54600B/ultrasonic-beacon/electronics/knowles_mic_v2/sum.asc

C1: cap; 10n
C2: cap; 1n
R1: res; 1000
R2: res; 10k
R3: res; 2k
R4: res; 50
U1: LT6233-10
V1: voltage; 3.3
V2: voltage; SINE(0 10m 40k); AC 1.
V3: voltage; 1.65
Named nets: 0, +3V3, +1V6, out
.ac oct 100 100 100meg
;tran 0 100m 99m startup
