54600B/ultrasonic-beacon/electronics/baseboard_v3rf/dac_filter.asc

C1: cap; 1n
C2: cap; 1n
R1: res; 3k3
R2: res; 8k2
R3: res; 330
U1: LT1007
V1: voltage; 10
V2: voltage; AC 1.
Named nets: 0
.ac oct 100 1k 100meg
