54600B/ultrasonic-beacon/electronics/knowles_mic_v2/knowles_mic_v2.brd

## EAGLE design electronics/knowles_mic_v2/knowles_mic_v2.brd (2018-10-21)

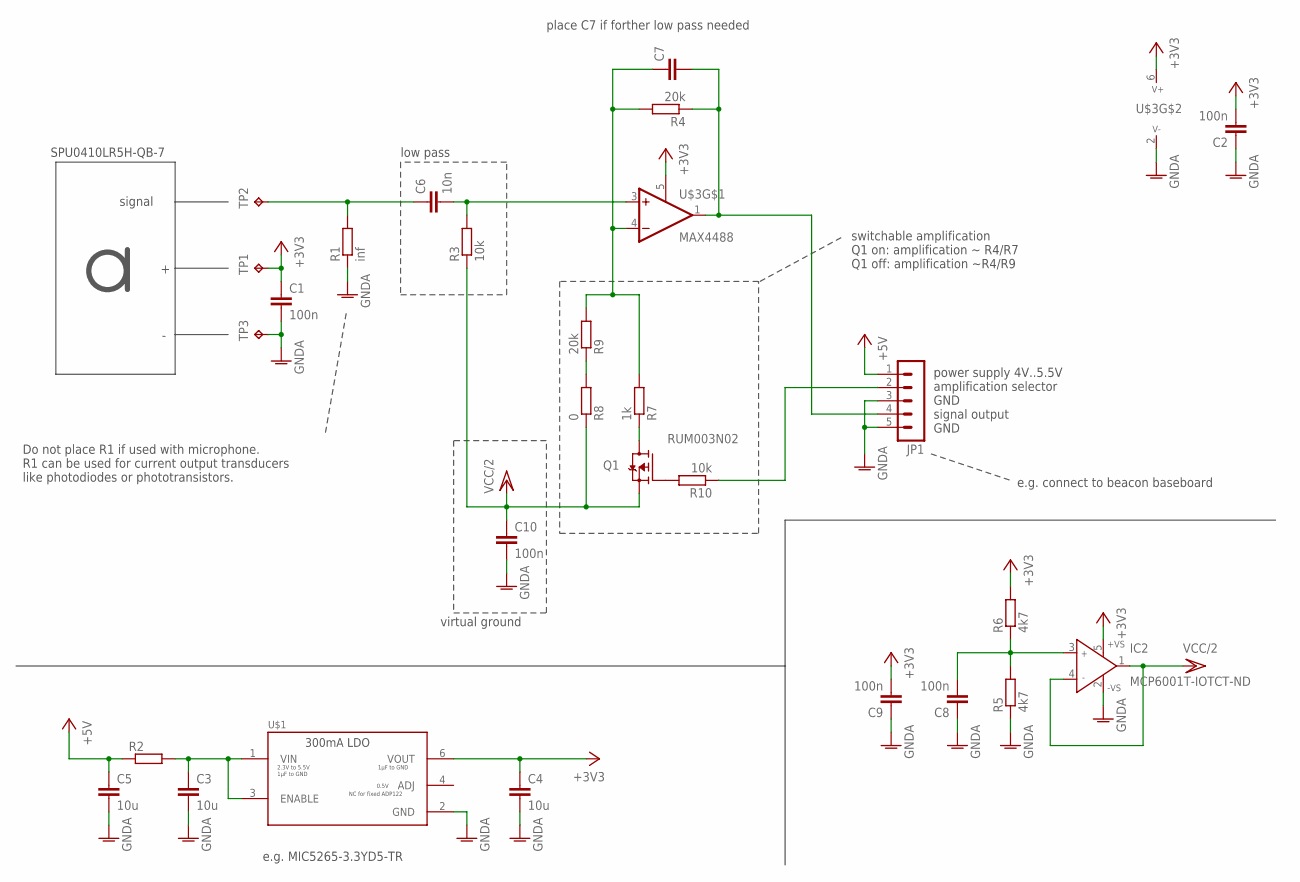
[picture p13: schematic knowles_mic_v2.sch]

Parts:
C1, C2, C8, C9, C10: 100n; C0603
C3, C4, C5: 10u; C0805
C6: 10n; C0603
C7: C-EUC0603; C0603
IC2: MCP6001T-IOTCT-ND; SOT23-5
JP1: PSS_5G; 22-23-2051
Q1: RUM003N02; SC75_INFINEON
R1: inf; R0603
R2: R-EU_R0603; R0603
R3, R10: 10k; R0603
R4, R9: 20k; R0603
R5, R6: 4k7; R0603
R7: 1k; R0603
R8: 0; R0603
TP1, TP2, TP3: TPTP06R; TP06R
U$1: ADP123; TSOT23-6
U$3: MAX4488; TSOT23-6

Connections:
+3V3: C1.1, C2.2, C4.1, C9.2, IC2.5 (+VS), R6.2, TP1.TP, U$1.6 (VOUT), U$3.5 (EN), U$3.6 (V+)
+5V: C5.1, JP1.1, R2.1
GNDA: C1.2, C2.1, C3.2, C4.2, C5.2, C8.1, C9.1, C10.2, IC2.2 (-VS), JP1.3, JP1.5, R1.1, R5.1, TP3.TP, U$1.2 (GND), U$3.2 (V-)
unnamed: C8.2, IC2.3 (IN+), R5.2, R6.1
unnamed: R8.2, R9.1
unnamed: C3.1, R2.2, U$1.1 (VIN), U$1.3 (ENABLE)
unnamed: JP1.2, R10.1
unnamed: Q1.1 (G), R10.2
unnamed: Q1.2 (D), R7.1
unnamed: C6.1, R1.2, TP2.TP
unnamed: C6.2, R3.2, U$3.3 (+IN)
unnamed: C7.2, JP1.4, R4.1, U$3.1 (OUT)
unnamed: C7.1, R4.2, R7.2, R9.2, U$3.4 (-IN)
VCC/2: C10.1, IC2.1 (OUT), IC2.4 (IN-), Q1.3 (S), R3.1, R8.1

Notes on the sheet:
e.g. MIC5265-3.3YD5-TR
signal
SPU0410LR5H-QB-7
Do not place R1 if used with microphone. R1 can be used for current output transducers like photodiodes or phototransistors.
low pass
place C7 if forther low pass needed
virtual ground
switchable amplification Q1 on: amplification ~ R4/R7 Q1 off: amplification ~R4/R9
power supply 4V..5.5V amplification selector GND signal output GND
e.g. connect to beacon baseboard

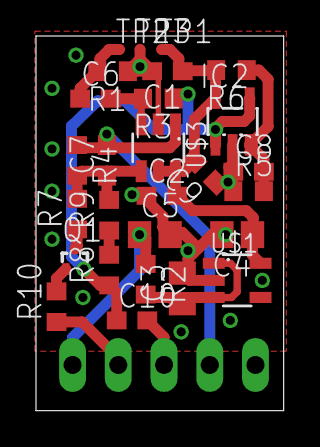
[picture p14: board knowles_mic_v2.brd from above]

Board: 2 copper layers, 13.8 x 20.8 mm, 28 parts (1 on the bottom side), 14 nets.
