54600B/ultrasonic-beacon/electronics/baseboard_v3rf/us_beacon_base_v3rf.brd

## EAGLE design electronics/baseboard_v3rf/us_beacon_base_v3rf.brd (2018-07-22)

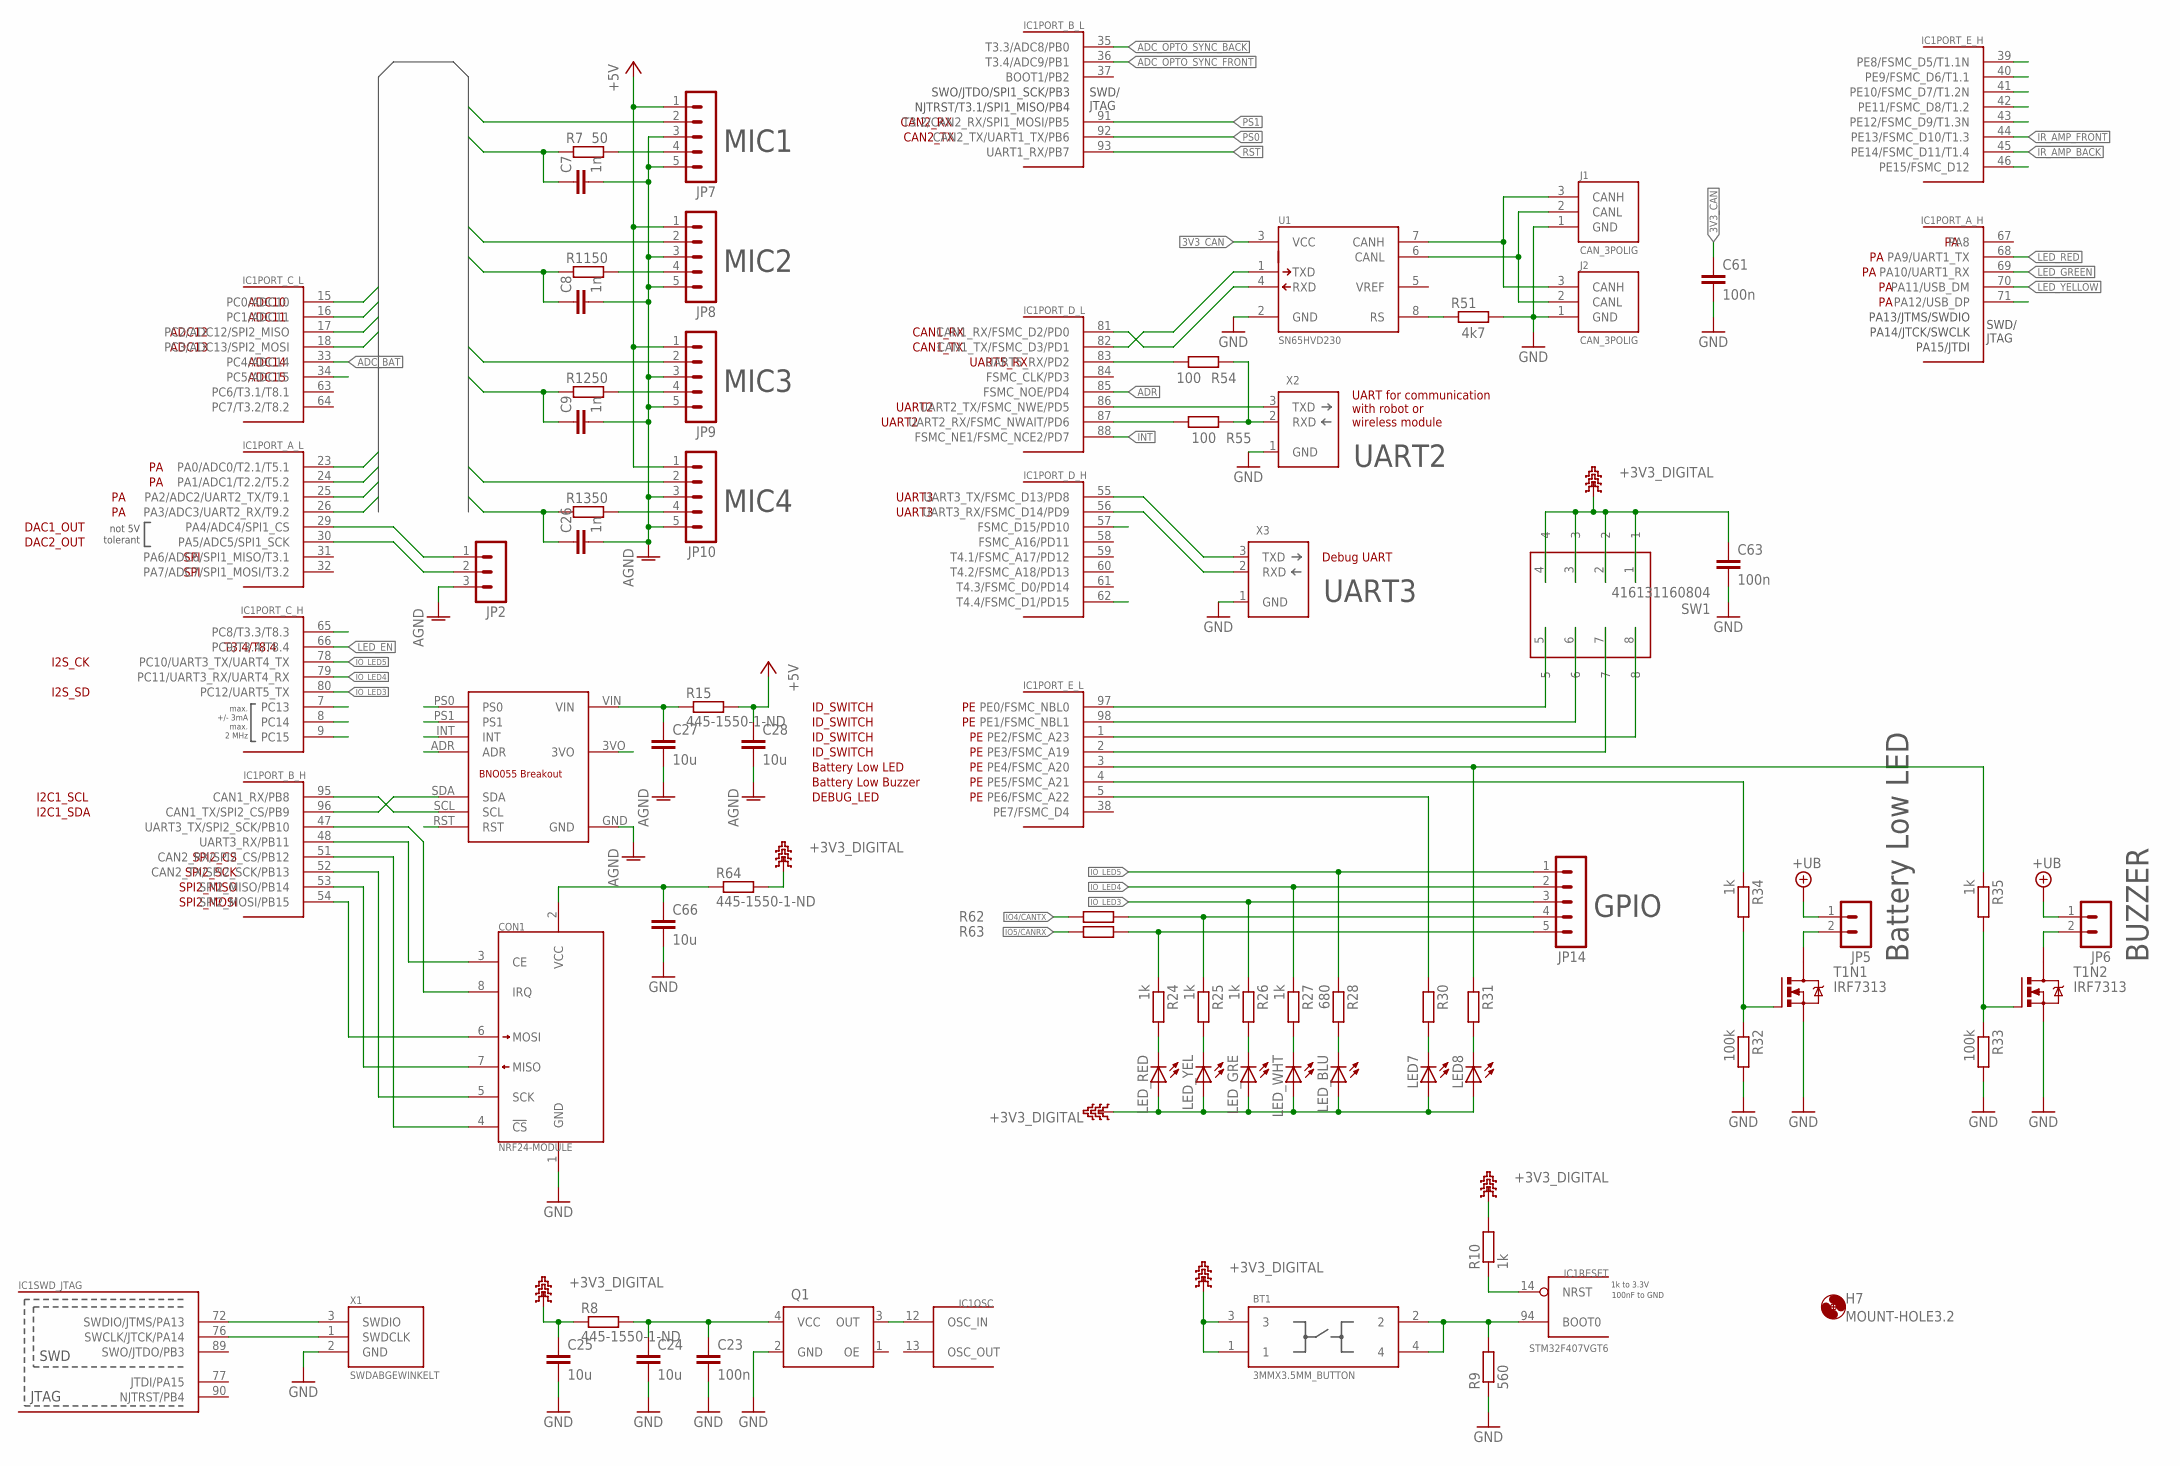
[picture p15: schematic us_beacon_base_v3rf.sch, sheet 1]

Parts:
BT1: 3MMX3.5MM_BUTTON
C7, C8, C9, C26: 1n; C0603
C23, C61, C63: 100n; C0603
C24, C25, C27, C28, C66: 10u; C0805
CON1: NRF24-MODULE
H7: MOUNT-HOLE3.2; 3,2
IC1: STM32F407VGT6; TQFP100
J1, J2: CAN_3POLIG; 7395-03
JP2: PSS_3G; 22-23-2031
JP5, JP6: PSS_2G; 22-23-2021
JP7, JP8, JP9, JP10, JP14: PSS_5G; 22-23-2051
LED7, LED8: LEDCHIP-LED0603; CHIP-LED0603
LED_BLU: LEDCHIP-LED0603; CHIP-LED0603
LED_GRE: LEDCHIP-LED0603; CHIP-LED0603
LED_RED: LEDCHIP-LED0603; CHIP-LED0603
LED_WHT: LEDCHIP-LED0603; CHIP-LED0603
LED_YEL: LEDCHIP-LED0603; CHIP-LED0603
Q1: XO53
R7, R11, R12, R13: 50; R0603
R8, R15, R64: 445-1550-1-ND; R0603
R9: 560; R0603
R10, R24, R25, R26, R27, R34, R35: 1k; R0603
R28: 680; R0603
R30, R31, R62, R63: R-EU_R0603; R0603
R32, R33: 100k; R0603
R51: 4k7; R0603
R54, R55: 100; R0603
SW1: 416131160804
T1: IRF7313; SO08
U1: SN65HVD230; SOIC-8
U$1: BNO055_ADAFRUIT_BREAKOUT; BNO055_BREAKOUT
X1: SWDABGEWINKELT; 7395-03
X2, X3: SERIAL_DEBUG_3PINL; 7395-03

Connections:
3V3_CAN: C61.1, U1.3 (VCC); also elsewhere on the board
+3V3_DIGITAL: BT1.1, BT1.3, C25.1, C63.1, LED7.A, LED8.A, LED_BLU.A, LED_GRE.A, LED_RED.A, LED_WHT.A, LED_YEL.A, R8.1, R10.2, R64.2, SW1.1, SW1.2, SW1.3, SW1.4; also elsewhere on the board
+5V: C28.1, JP7.1, JP8.1, JP9.1, JP10.1, R15.2; also elsewhere on the board
+UB: JP5.1, JP6.1; also elsewhere on the board
ADC_BAT: IC1.33 (PC4/ADC14); also elsewhere on the board
ADC_OPTO_SYNC_BACK: IC1.35 (T3.3/ADC8/PB0); also elsewhere on the board
ADC_OPTO_SYNC_FRONT: IC1.36 (T3.4/ADC9/PB1); also elsewhere on the board
ADR: IC1.85 (FSMC_NOE/PD4), U$1.ADR
AMP1: IC1.23 (PA0/ADC0/T2.1/T5.1), JP7.2
AMP2: IC1.24 (PA1/ADC1/T2.2/T5.2), JP8.2
AMP3: IC1.25 (PA2/ADC2/UART2_TX/T9.1), JP9.2
AMP4: IC1.26 (PA3/ADC3/UART2_RX/T9.2), JP10.2
DAC1/I2S1_WS: IC1.29 (PA4/ADC4/SPI1_CS), JP2.1
DAC2/SPI1_SCK: IC1.30 (PA5/ADC5/SPI1_SCK), JP2.2
GND: C7.2, C8.2, C9.2, C23.2, C24.2, C25.2, C26.2, C27.2, C28.2, C61.2, C63.2, C66.2, CON1.1 (GND), J1.1 (GND), J2.1 (GND), JP2.3, JP7.3, JP7.5, JP8.3, JP8.5, JP9.3, JP9.5, JP10.3, JP10.5, Q1.2 (GND), R9.1, R32.2, R33.2, R51.2, T1.1 (S), T1.3 (S), U1.2 (GND), U$1.GND, X1.2 (GND), X2.1 (GND), X3.1 (GND); also elsewhere on the board
INT: IC1.88 (FSMC_NE1/FSMC_NCE2/PD7), U$1.INT
IO4: JP14.4, R25.1, R62.2
IO4/CANTX: IC1.82 (CAN1_TX/FSMC_D3/PD1), R62.1, U1.1 (TXD)
IO5: JP14.5, R24.1, R63.2
IO5/CANRX: IC1.81 (CAN1_RX/FSMC_D2/PD0), R63.1, U1.4 (RXD)
IO_LED3: IC1.80 (PC12/UART5_TX), JP14.3, R26.1
IO_LED4: IC1.79 (PC11/UART3_RX/UART4_RX), JP14.2, R27.1
IO_LED5: IC1.78 (PC10/UART3_TX/UART4_TX), JP14.1, R28.1
IR_AMP_BACK: IC1.45 (PE14/FSMC_D11/T1.4); also elsewhere on the board
IR_AMP_FRONT: IC1.44 (PE13/FSMC_D10/T1.3); also elsewhere on the board
LED_EN: IC1.66 (PC9/T3.4/T8.4); also elsewhere on the board
LED_GREEN: IC1.69 (PA10/UART1_RX); also elsewhere on the board
LED_RED: IC1.68 (PA9/UART1_TX); also elsewhere on the board
LED_YELLOW: IC1.70 (PA11/USB_DM); also elsewhere on the board
MIC1: C7.1, IC1.15 (PC0/ADC10), R7.1
MIC2: C8.1, IC1.16 (PC1/ADC11), R11.1
MIC3: C9.1, IC1.17 (PC2/ADC12/SPI2_MISO), R12.1
MIC4: C26.1, IC1.18 (PC3/ADC13/SPI2_MOSI), R13.1
unnamed: IC1.72 (SWDIO/JTMS/PA13), X1.3 (SWDIO)
unnamed: IC1.76 (SWCLK/JTCK/PA14), X1.1 (SWDCLK)
unnamed: JP7.4, R7.2
unnamed: IC1.12 (OSC_IN), Q1.3 (OUT)
unnamed: C23.1, C24.1, Q1.4 (VCC), R8.2
unnamed: JP9.4, R12.2
unnamed: IC1.14 (NRST), R10.1
unnamed: JP8.4, R11.2
unnamed: JP10.4, R13.2
unnamed: BT1.2, BT1.4, IC1.94 (BOOT0), R9.2
unnamed: IC1.83 (UART5_RX/PD2), R54.1
unnamed: C27.1, R15.1, U$1.VIN
unnamed: R54.2, R55.2, X2.2 (RXD)
unnamed: IC1.95 (CAN1_RX/PB8), U$1.SCL
unnamed: IC1.96 (CAN1_TX/SPI2_CS/PB9), U$1.SDA
unnamed: IC1.86 (UART2_TX/FSMC_NWE/PD5), X2.3 (TXD)
unnamed: IC1.87 (UART2_RX/FSMC_NWAIT/PD6), R55.1
unnamed: IC1.55 (UART3_TX/FSMC_D13/PD8), X3.3 (TXD)
unnamed: IC1.56 (UART3_RX/FSMC_D14/PD9), X3.2 (RXD)
unnamed: LED_RED.C, R24.2
unnamed: LED_YEL.C, R25.2
unnamed: LED_GRE.C, R26.2
unnamed: LED_WHT.C, R27.2
unnamed: LED_BLU.C, R28.2
unnamed: LED7.C, R30.2
unnamed: LED8.C, R31.2
unnamed: IC1.3 (PE4/FSMC_A20), R31.1, R35.1
unnamed: IC1.5 (PE6/FSMC_A22), R30.1
unnamed: R32.1, R34.2, T1.2 (G)
unnamed: R33.1, R35.2, T1.4 (G)
unnamed: JP5.2, T1.7 (D)
unnamed: IC1.4 (PE5/FSMC_A21), R34.1
unnamed: JP6.2, T1.5 (D)
unnamed: IC1.2 (PE3/FSMC_A19), SW1.7
unnamed: IC1.97 (PE0/FSMC_NBL0), SW1.5
unnamed: IC1.98 (PE1/FSMC_NBL1), SW1.6
unnamed: IC1.1 (PE2/FSMC_A23), SW1.8
unnamed: R51.1, U1.8 (RS)
unnamed: J1.3 (CANH), J2.3 (CANH), U1.7 (CANH)
unnamed: J1.2 (CANL), J2.2 (CANL), U1.6 (CANL)
unnamed: CON1.4 (!CS), IC1.51 (CAN2_RX/SPI2_CS/PB12)
unnamed: CON1.5 (SCK), IC1.52 (CAN2_TX/SPI2_SCK/PB13)
unnamed: CON1.7 (MISO), IC1.53 (SPI2_MISO/PB14)
unnamed: CON1.6 (MOSI), IC1.54 (SPI2_MOSI/PB15)
unnamed: CON1.3 (CE), IC1.48 (UART3_RX/PB11)
unnamed: CON1.8 (IRQ), IC1.47 (UART3_TX/SPI2_SCK/PB10)
unnamed: C66.1, CON1.2 (VCC), R64.1
PS0: IC1.92 (CAN2_TX/UART1_TX/PB6), U$1.PS0
PS1: IC1.91 (T3.2/CAN2_RX/SPI1_MOSI/PB5), U$1.PS1
RST: IC1.93 (UART1_RX/PB7), U$1.RST
VBAT: IC1.6 (VBAT)

Notes on the sheet:
ADC11
SPI2_CS
SPI2_SCK
CAN1_RX
CAN1_TX
SPI2_MOSI
SPI2_MISO
ADC10
ADC14
ADC15
UART2
UART3
DAC1_OUT
DAC2_OUT
I2S_CK
I2S_SD
SPI
CAN2_RX
CAN2_TX
I2C1_SCL
I2C1_SDA
ADC12
ADC13
ID_SWITCH
Battery Low LED
Battery Low Buzzer
DEBUG_LED
MIC1
MIC2
MIC3
MIC4
GPIO
BUZZER
Debug UART
UART for communication with robot or wireless module
T3.4/T8.4
UART5_RX

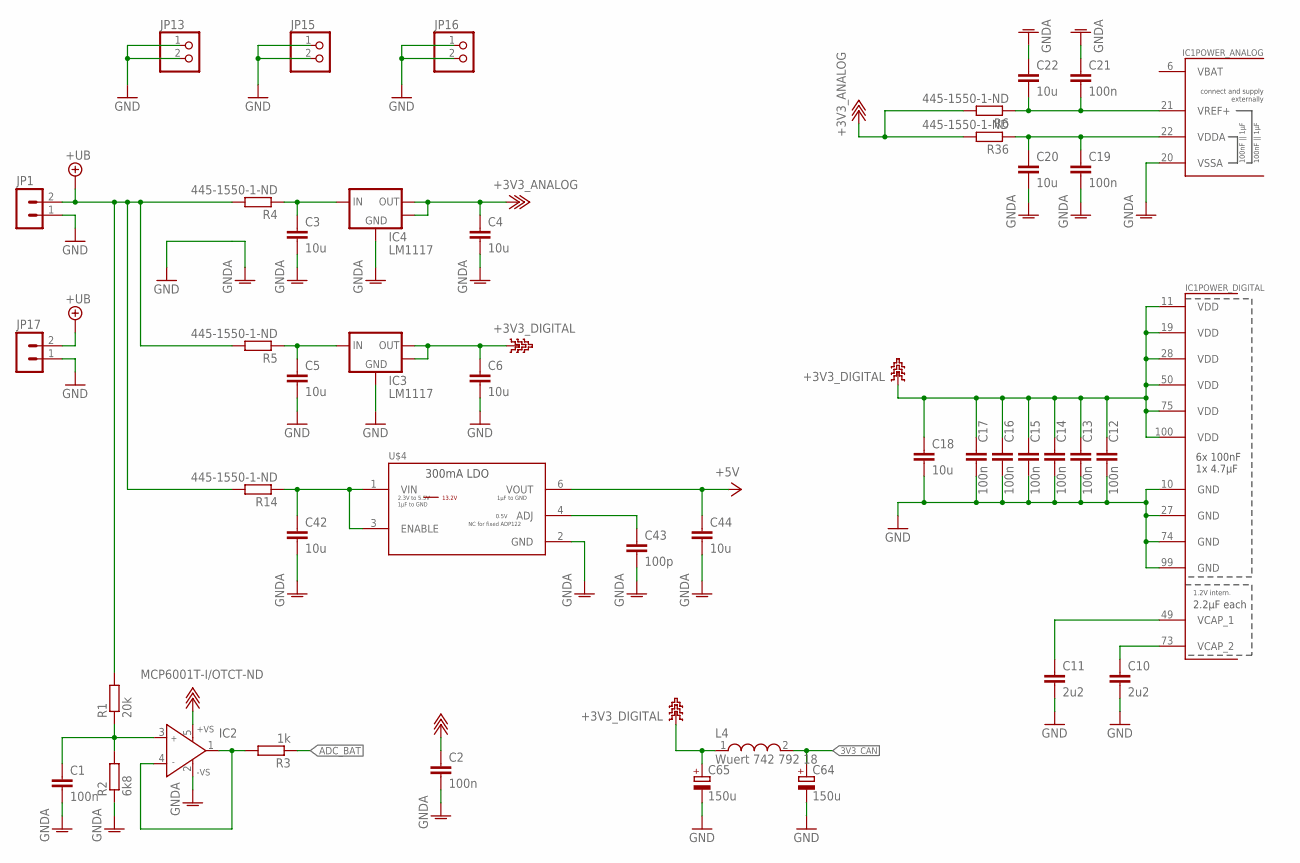
[picture p16: schematic us_beacon_base_v3rf.sch, sheet 2]

Parts:
C1, C2, C12, C13, C14, C15, C16, C17, C19, C21: 100n; C0603
C3, C4, C5, C6, C18, C20, C22, C42, C44: 10u; C0805
C10, C11: 2u2; C0805
C43: 100p; C0603
C64, C65: 150u; E3,5-8
IC1: STM32F407VGT6; TQFP100
IC2: MCP6001T-I/OTCT-ND; SOT23-5
IC3, IC4: LM1117; SOT223
JP1, JP17: PSS_2G; 22-23-2021
JP13, JP15, JP16: PINHD-1X2; 1X02
L4: Wuert 742 792 18; WE-CBF_1206(W=5.2)
R1: 20k; R0603
R2: 6k8; R0603
R3: 1k; R0603
R4, R5, R6, R14, R36: 445-1550-1-ND; R0603
U$4: AP2210K-5.0; TSOT23-6

Connections:
3V3_CAN: C64.+, L4.2; also elsewhere on the board
+3V3_ANALOG: C2.1, C4.1, IC2.5 (+VS), IC4.2 (OUT), IC4.4 (OUT), R6.2, R36.2; also elsewhere on the board
+3V3_DIGITAL: C6.1, C12.1, C13.1, C14.1, C15.1, C16.1, C17.1, C18.1, C65.+, IC1.11 (VDD), IC1.19 (VDD), IC1.28 (VDD), IC1.50 (VDD), IC1.75 (VDD), IC1.100 (VDD), IC3.2 (OUT), IC3.4 (OUT), L4.1; also elsewhere on the board
+5V: C44.1, U$4.6 (VOUT); also elsewhere on the board
+UB: JP1.2, JP17.2, R1.2, R4.2, R5.2, R14.2; also elsewhere on the board
ADC_BAT: R3.1; also elsewhere on the board
GND: C1.2, C2.2, C3.2, C4.2, C5.2, C6.2, C10.2, C11.2, C12.2, C13.2, C14.2, C15.2, C16.2, C17.2, C18.2, C19.2, C20.2, C21.1, C22.1, C42.2, C43.2, C44.2, C64.-, C65.-, IC1.10 (GND), IC1.20 (VSSA), IC1.27 (GND), IC1.74 (GND), IC1.99 (GND), IC2.2 (-VS), IC3.1 (GND), IC4.1 (GND), JP1.1, JP13.1, JP13.2, JP15.1, JP15.2, JP16.1, JP16.2, JP17.1, R2.1, U$4.2 (GND); also elsewhere on the board
unnamed: IC2.1 (OUT), IC2.4 (IN-), R3.2
unnamed: C1.1, IC2.3 (IN+), R1.1, R2.2
unnamed: C42.1, R14.1, U$4.1 (VIN), U$4.3 (ENABLE)
unnamed: C3.1, IC4.3 (IN), R4.1
unnamed: C10.1, IC1.73 (VCAP_2)
unnamed: C5.1, IC3.3 (IN), R5.1
unnamed: C11.1, IC1.49 (VCAP_1)
unnamed: C21.2, C22.2, IC1.21 (VREF+), R6.1
unnamed: C43.1, U$4.4 (ADJ)
unnamed: C19.1, C20.1, IC1.22 (VDDA), R36.1
VBAT: IC1.6 (VBAT)

Notes on the sheet:
13.2V

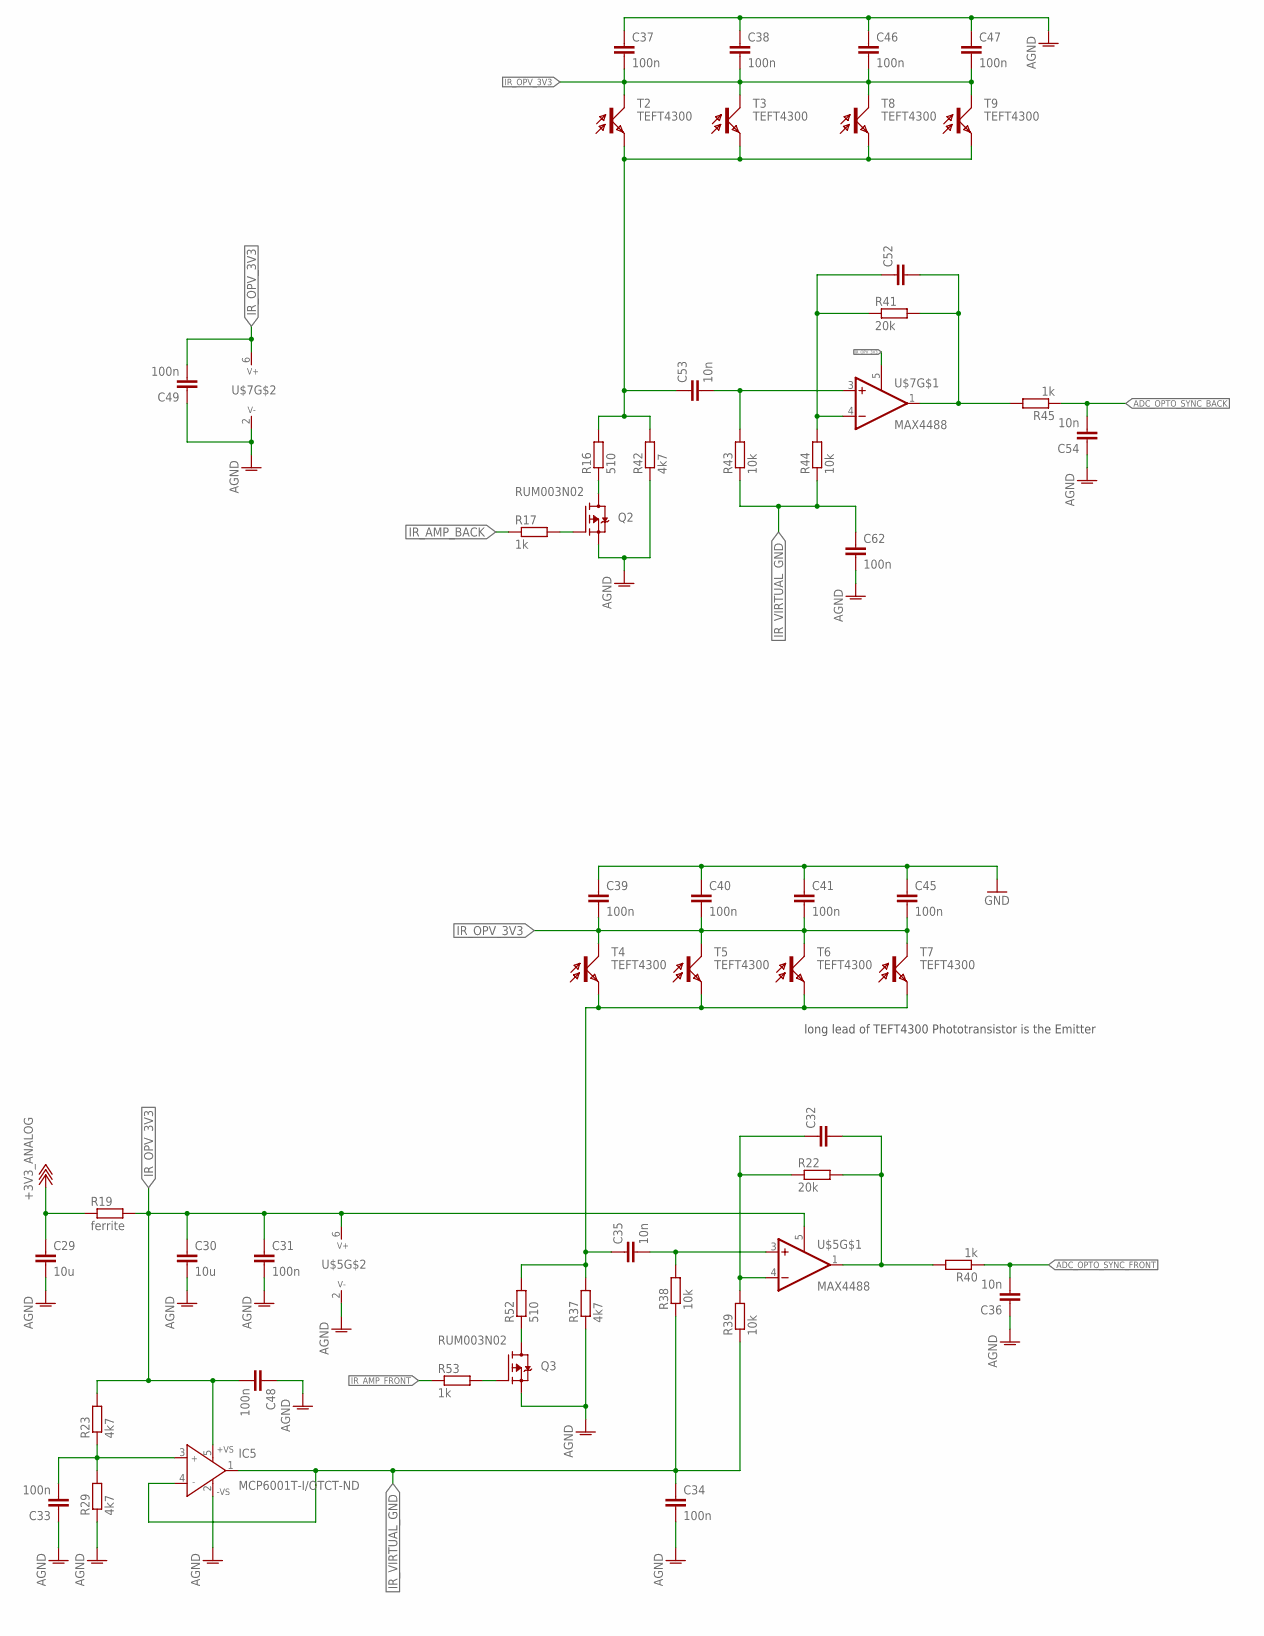
[picture p17: schematic us_beacon_base_v3rf.sch, sheet 3]

Parts:
C29, C30: 10u; C0805
C31, C33, C34, C37, C38, C39, C40, C41, C45, C46, C47, C48, C49, C62: 100n; C0603
C32, C52: C-EUC0603; C0603
C35, C36, C53, C54: 10n; C0603
IC5: MCP6001T-I/OTCT-ND; SOT23-5
Q2, Q3: RUM003N02; SC75_INFINEON
R16, R52: 510; R0603
R17, R40, R45, R53: 1k; R0603
R19: ferrite; R0603
R22, R41: 20k; R0603
R23, R29, R37, R42: 4k7; R0603
R38, R39, R43, R44: 10k; R0603
T2, T3, T4, T5, T6, T7, T8, T9: TEFT4300; LPT80A
U$5, U$7: MAX4488; TSOT23-6

Connections:
+3V3_ANALOG: C29.1, R19.1; also elsewhere on the board
ADC_OPTO_SYNC_BACK: C54.2, R45.1; also elsewhere on the board
ADC_OPTO_SYNC_FRONT: C36.2, R40.1; also elsewhere on the board
GND: C29.2, C30.2, C31.2, C33.1, C34.2, C36.1, C37.1, C38.1, C39.1, C40.1, C41.1, C45.1, C46.1, C47.1, C48.1, C49.1, C54.1, C62.2, IC5.2 (-VS), Q2.3 (S), Q3.3 (S), R29.1, R37.1, R42.1, U$5.2 (V-), U$7.2 (V-); also elsewhere on the board
IR_AMP_BACK: R17.1; also elsewhere on the board
IR_AMP_FRONT: R53.1; also elsewhere on the board
IR_OPV_3V3: C30.1, C31.1, C37.2, C38.2, C39.2, C40.2, C41.2, C45.2, C46.2, C47.2, C48.2, C49.2, IC5.5 (+VS), R19.2, R23.2, T2.C, T3.C, T4.C, T5.C, T6.C, T7.C, T8.C, T9.C, U$5.5 (EN), U$5.6 (V+), U$7.5 (EN), U$7.6 (V+)
IR_VIRTUAL_GND: C34.1, C62.1, IC5.1 (OUT), IC5.4 (IN-), R38.1, R39.1, R43.1, R44.1
unnamed: Q2.2 (D), R16.1
unnamed: Q2.1 (G), R17.2
unnamed: C53.1, R16.2, R42.2, T2.E, T3.E, T8.E, T9.E
unnamed: C35.2, R38.2, U$5.3 (+IN)
unnamed: Q3.2 (D), R52.1
unnamed: C32.2, R22.2, R40.2, U$5.1 (OUT)
unnamed: C32.1, R22.1, R39.2, U$5.4 (-IN)
unnamed: Q3.1 (G), R53.2
unnamed: C33.2, IC5.3 (IN+), R23.1, R29.2
unnamed: C52.2, R41.2, R45.2, U$7.1 (OUT)
unnamed: C52.1, R41.1, R44.2, U$7.4 (-IN)
unnamed: C35.1, R37.2, R52.2, T4.E, T5.E, T6.E, T7.E
unnamed: C53.2, R43.2, U$7.3 (+IN)

Notes on the sheet:
long lead of TEFT4300 Phototransistor is the Emitter

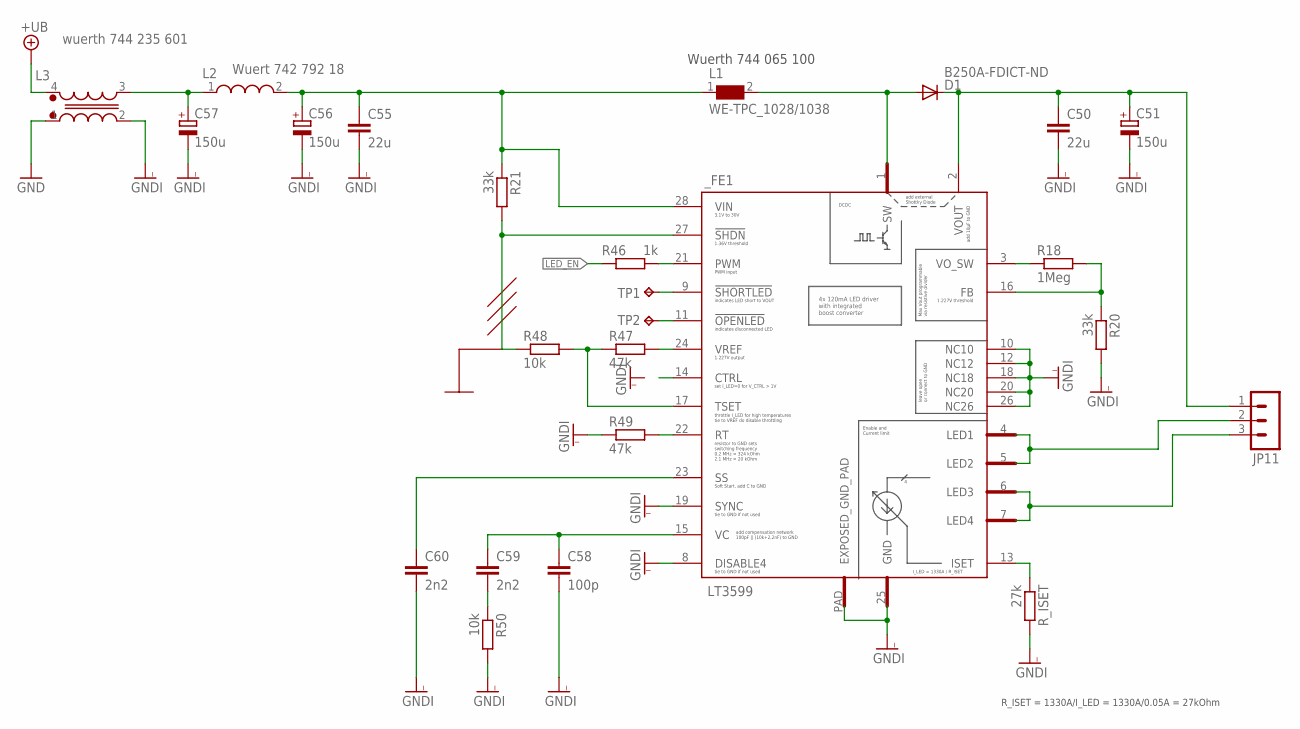
[picture p18: schematic us_beacon_base_v3rf.sch, sheet 4]

Parts:
C50, C55: 22u; C1206
C51, C56, C57: 150u; E3,5-8
C58: 100p; C0603
C59, C60: 2n2; C0603
D1: B250A-FDICT-ND; SMB
JP11: PSS_3G; 22-23-2031
L1: WE-TPC_1028/1038
L2: Wuert 742 792 18; WE-CBF_1206(W=5.2)
L3: wuerth 744 235 601; WE-CNSW_1812
R18: 1Meg; R0603
R20, R21: 33k; R0603
R46: 1k; R0603
R47, R49: 47k; R0603
R48, R50: 10k; R0603
R_ISET: 27k; R0603
TP1, TP2: TPTP06R; TP06R
_FE1: LT3599; TSSOP28

Connections:
+UB: L3.4 (1); also elsewhere on the board
DCDC_SW_NODE: D1.A, L1.2, _FE1.1 (SW)
GND: L3.1 (4); also elsewhere on the board
GNDI: C50.2, C51.-, C55.2, C56.-, C57.-, C58.2, C60.2, L3.2 (3), R20.2, R49.1, R50.2, R_ISET.2, _FE1.8 (DISABLE4), _FE1.10 (NC10), _FE1.12 (NC12), _FE1.18 (NC18), _FE1.19 (SYNC), _FE1.20 (NC20), _FE1.25 (GND), _FE1.26 (NC26), _FE1.PAD (EXPOSED_GND_PAD)
LED_EN: R46.1; also elsewhere on the board
unnamed: R46.2, _FE1.21 (PWM)
unnamed: C57.+, L2.1, L3.3 (2)
unnamed: C58.1, C59.1, _FE1.15 (VC)
unnamed: C50.1, C51.+, D1.C, JP11.1, _FE1.2 (VOUT)
unnamed: JP11.2, _FE1.4 (LED1), _FE1.5 (LED2)
unnamed: JP11.3, _FE1.6 (LED3), _FE1.7 (LED4)
unnamed: R18.2, R20.1, _FE1.16 (FB)
unnamed: R18.1, _FE1.3 (VO_SW)
unnamed: TP1.TP, _FE1.9 (!SHORTLED)
unnamed: TP2.TP, _FE1.11 (!OPENLED)
unnamed: R47.1, R48.2, _FE1.17 (TSET)
unnamed: R47.2, _FE1.24 (VREF)
unnamed: R21.2, R48.1, _FE1.27 (!SHDN)
unnamed: C55.1, C56.+, L1.1, L2.2, R21.1, _FE1.28 (VIN)
unnamed: R49.2, _FE1.22 (RT)
unnamed: C60.1, _FE1.23 (SS)
unnamed: C59.2, R50.1
unnamed: R_ISET.1, _FE1.13 (ISET)

Notes on the sheet:
R_ISET = 1330A/I_LED = 1330A/0.05A = 27kOhm
Wuerth 744 065 100

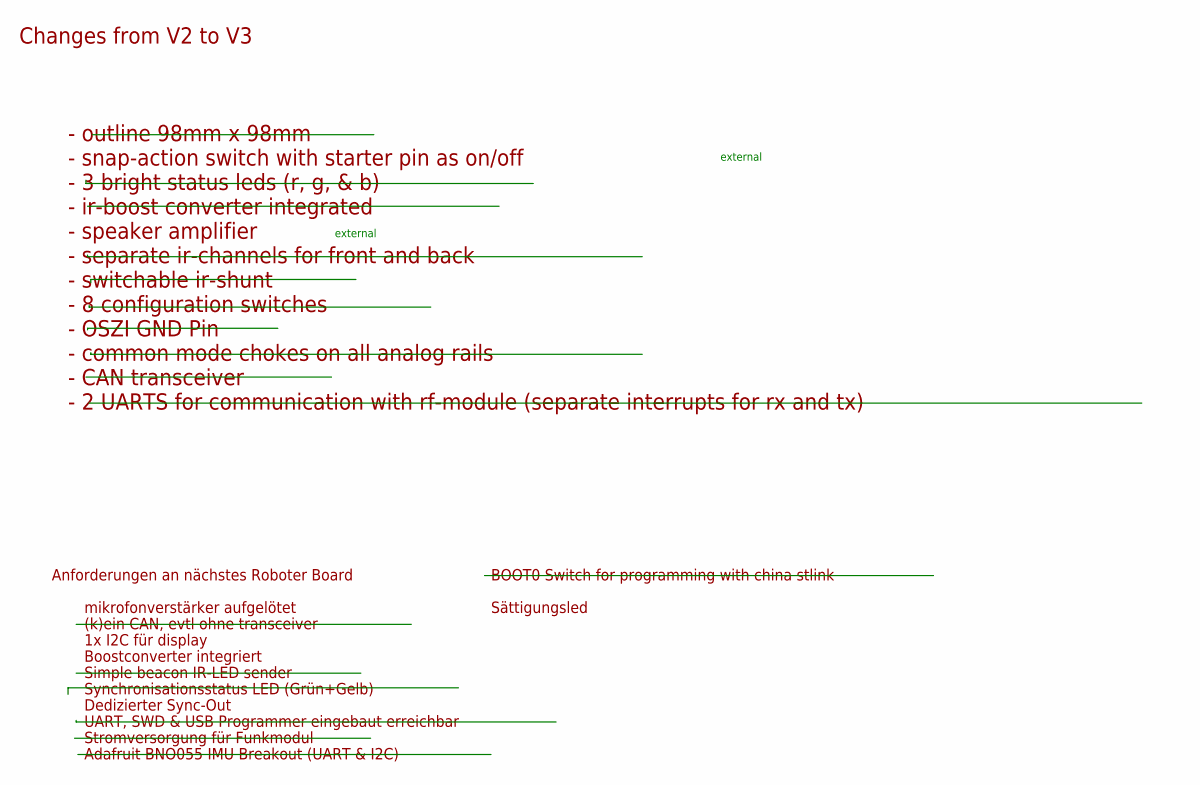
[picture p19: schematic us_beacon_base_v3rf.sch, sheet 5]

Notes on the sheet:
- outline 98mm x 98mm - snap-action switch with starter pin as on/off - 3 bright status leds (r, g, & b) - ir-boost converter integrated - speaker amplifier - separate ir-channels for front and back - switchable ir-shunt - 8 configuration switches - OSZI GND Pin - common mode chokes on all analog r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
Changes from V2 to V3
BOOT0 Switch for programming with china stlink
Sättigungsled
Anforderungen an nächstes Roboter Board
mikrofonverstärker aufgelötet
(k)ein CAN, evtl ohne transceiver
1x I2C für display
Boostconverter integriert
Simple beacon IR-LED sender
Synchronisationsstatus LED (Grün+Gelb)
Dedizierter Sync-Out
UART, SWD & USB Programmer eingebaut erreichbar
Stromversorgung für Funkmodul
Adafruit BNO055 IMU Breakout (UART & I2C)
external

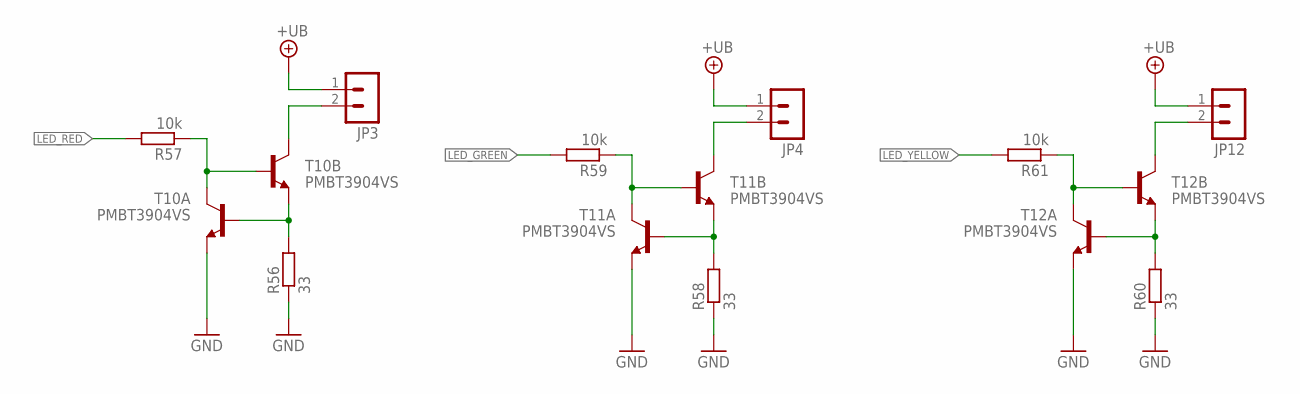
[picture p20: schematic us_beacon_base_v3rf.sch, sheet 6]

Parts:
JP3, JP4, JP12: PSS_2G; 22-23-2021
R56, R58, R60: 33; R0603
R57, R59, R61: 10k; R0603
T10, T11, T12: PMBT3904VS; SOT563

Connections:
+UB: JP3.1, JP4.1, JP12.1; also elsewhere on the board
GND: R56.1, R58.1, R60.1, T10.1 (E), T11.1 (E), T12.1 (E); also elsewhere on the board
LED_GREEN: R59.2; also elsewhere on the board
LED_RED: R57.2; also elsewhere on the board
LED_YELLOW: R61.2; also elsewhere on the board
unnamed: R56.2, T10.2 (B), T10.4 (E)
unnamed: R57.1, T10.5 (B), T10.6 (C)
unnamed: JP3.2, T10.3 (C)
unnamed: R58.2, T11.2 (B), T11.4 (E)
unnamed: R59.1, T11.5 (B), T11.6 (C)
unnamed: JP4.2, T11.3 (C)
unnamed: R60.2, T12.2 (B), T12.4 (E)
unnamed: R61.1, T12.5 (B), T12.6 (C)
unnamed: JP12.2, T12.3 (C)

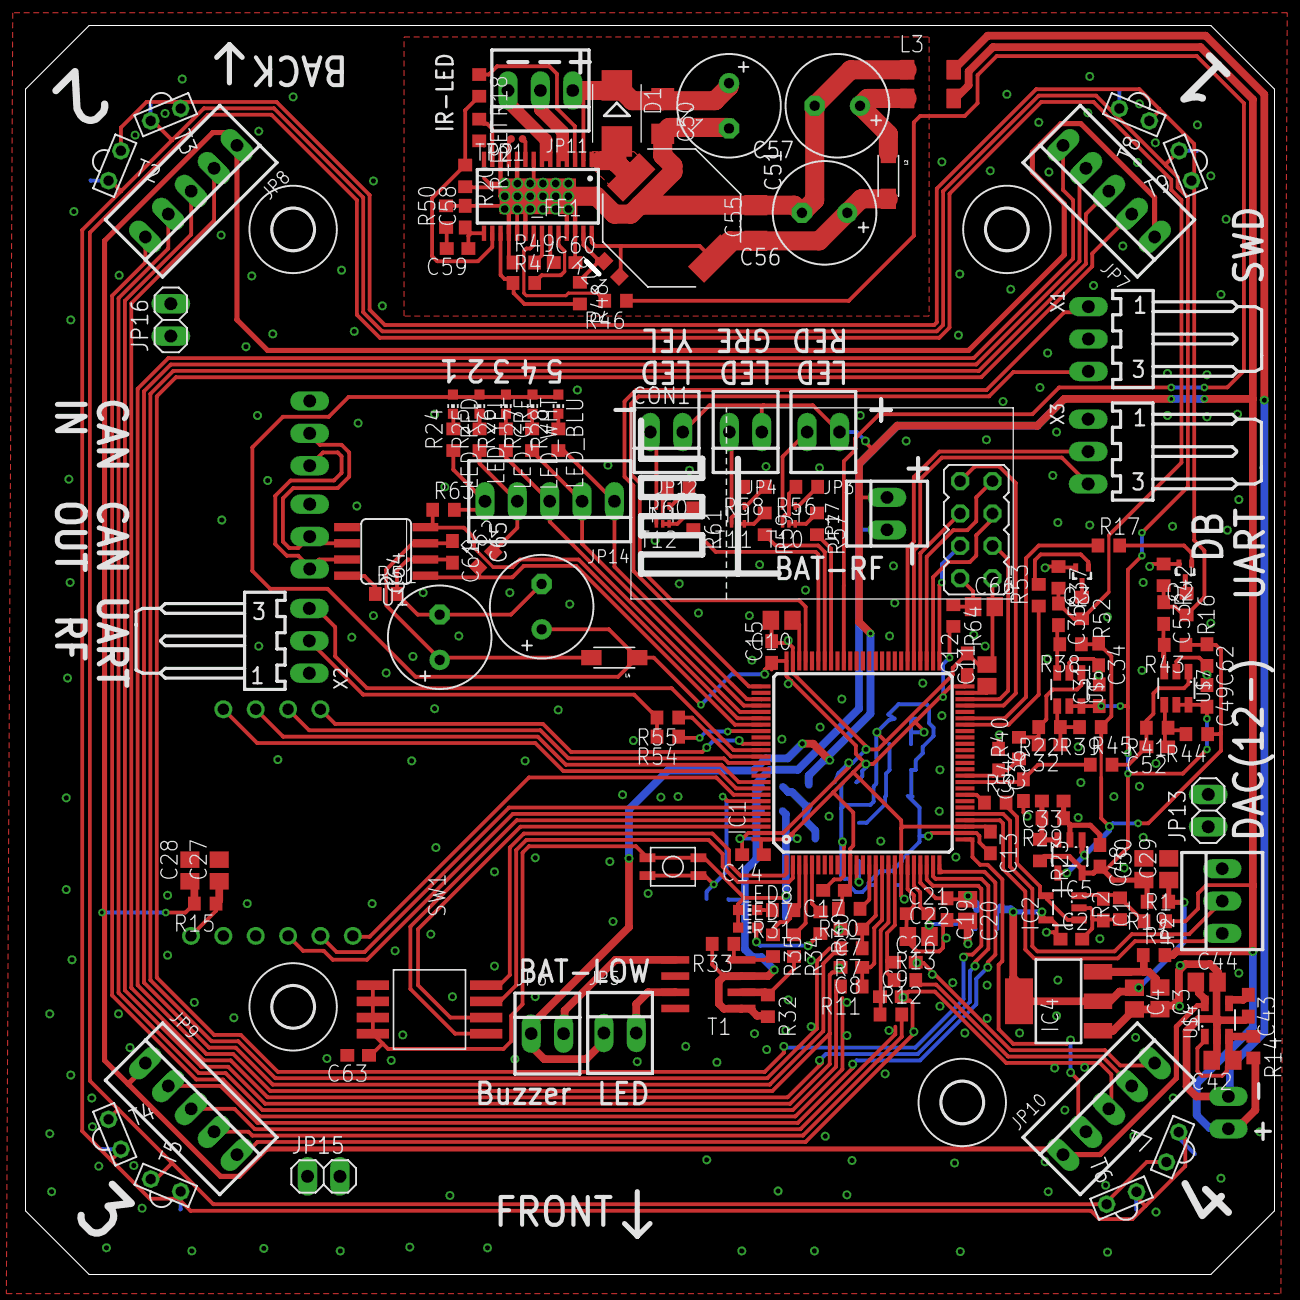
[picture p21: board us_beacon_base_v3rf.brd from above]

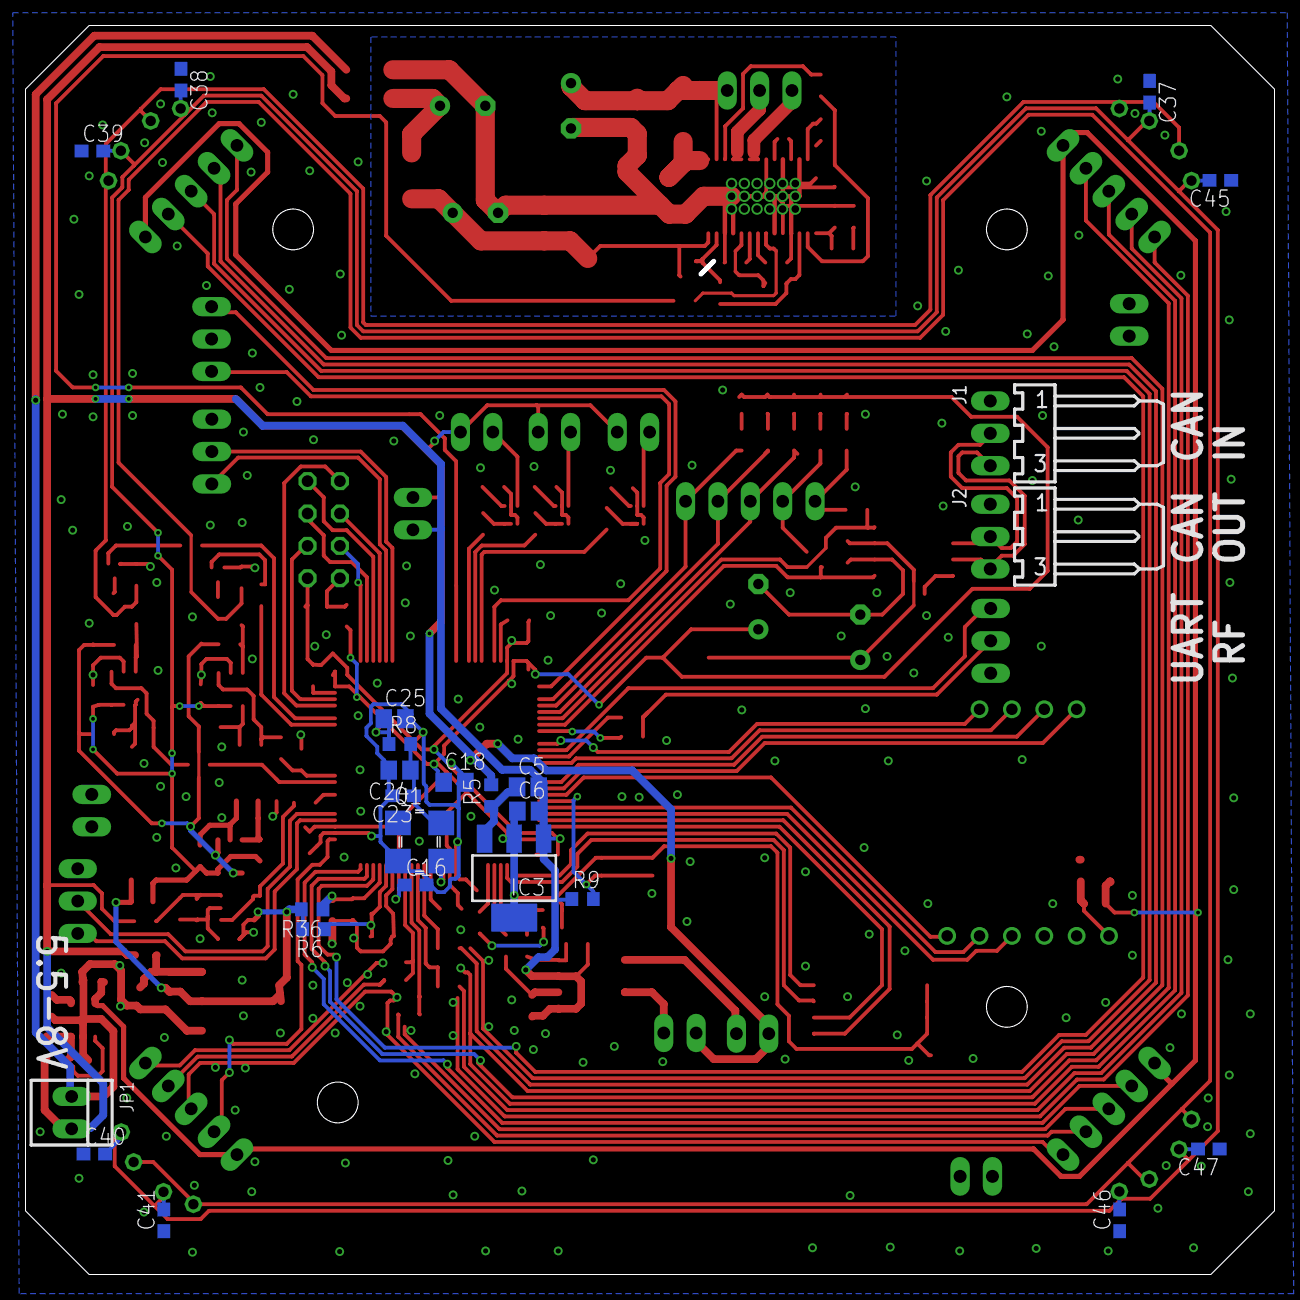
[picture p22: board us_beacon_base_v3rf.brd from below]

Board: 2 copper layers, 98.0 x 98.0 mm, 200 parts (25 on the bottom side), 138 nets.

Other parts of the board:
H5, H6, H8: MOUNT-HOLE3.2; 3,2
