54600B/ultrasonic-beacon/electronics/amplifier/amplifier_v3.brd

## EAGLE design electronics/amplifier/amplifier_v3.brd (2018-07-22)

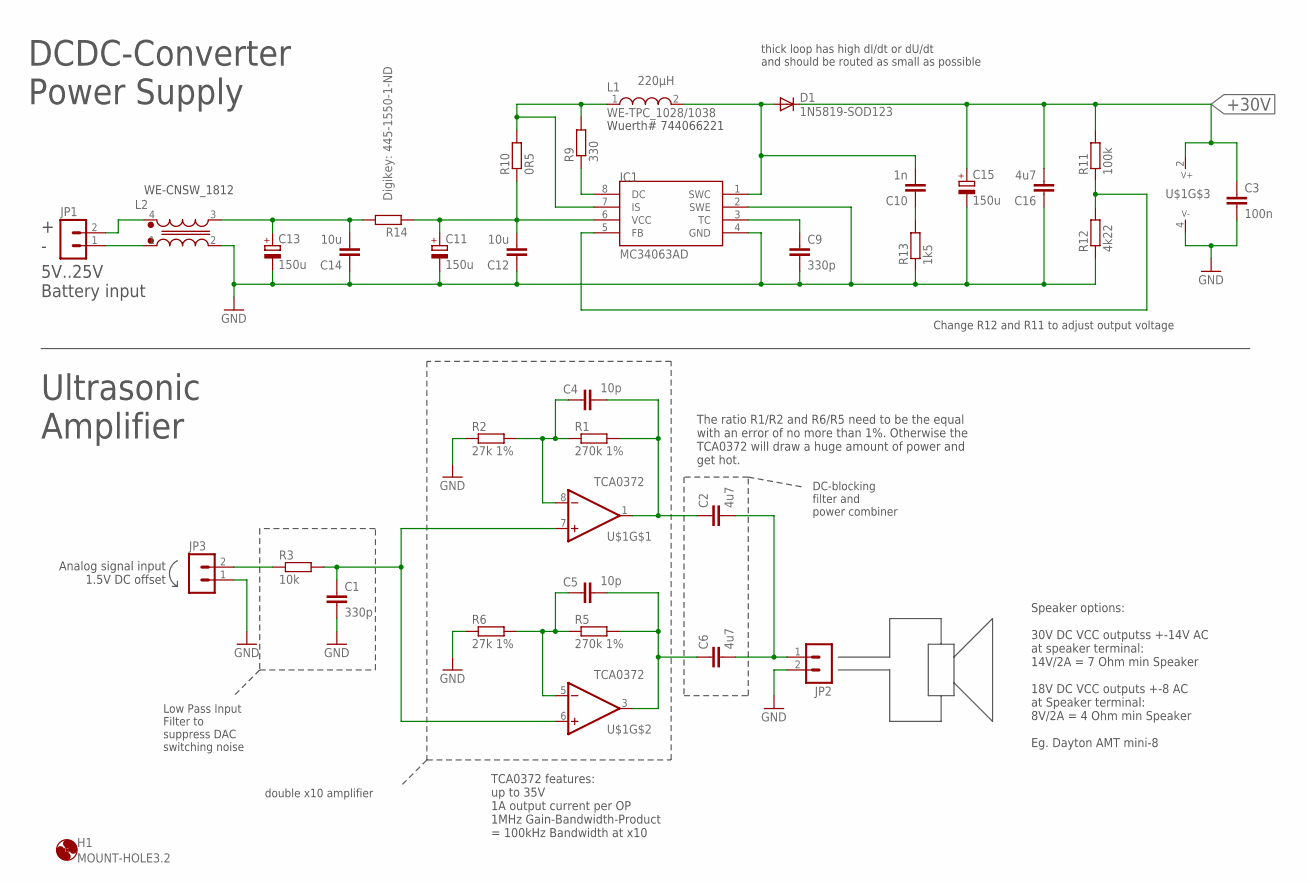
[picture p23: schematic amplifier_v3.sch]

Parts:
C1, C9: 330p; C0603
C2, C6, C16: 4u7; C0805
C3: 100n; C0603
C4, C5: 10p; C0603
C10: 1n; C0603
C11, C13, C15: 150u; E3,5-8
C12, C14: 10u; C0805
D1: 1N5819-SOD123; SOD123
H1: MOUNT-HOLE3.2; 3,2
IC1: MC34063AD; SOIC8
JP1, JP2, JP3: PSS_2G; 22-23-2021
L1: WE-TPC_1028/1038
L2: WE-CNSW_1812
R1, R5: 270k 1%; R0603
R2, R6: 27k 1%; R0603
R3: 10k; R0603
R9: 330; R0603
R10: 0R5; R0603
R11: 100k; R0603
R12: 4k22; R0603
R13: 1k5; R0603
R14: Digikey: 445-1550-1-ND; R0603
U$1: TCA0372; DIL08

Connections:
+30V: C3.1, C15.+, C16.2, D1.C, R11.2, U$1.2 (V+)
GND: C1.2, C3.2, C9.2, C11.-, C12.1, C13.-, C14.1, C15.-, C16.1, IC1.2 (SWE), IC1.4 (GND), JP2.2, JP3.1, L2.2 (3), R2.1, R6.1, R12.1, R13.1, U$1.4 (V-)
unnamed: JP3.2, R3.1
unnamed: C2.1, C4.2, R1.2, U$1.1 (OUT)
unnamed: C2.2, C6.2, JP2.1
unnamed: C4.1, R1.1, R2.2, U$1.8 (-IN)
unnamed: C1.1, R3.2, U$1.6 (+IN), U$1.7 (+IN)
unnamed: C5.2, C6.1, R5.2, U$1.3 (OUT)
unnamed: C5.1, R5.1, R6.2, U$1.5 (-IN)
unnamed: JP1.1, L2.1 (4)
unnamed: JP1.2, L2.4 (1)
unnamed: IC1.8 (DC), R9.1
unnamed: IC1.7 (IS), L1.1, R9.2, R10.2
unnamed: IC1.5 (FB), R11.1, R12.2
unnamed: C9.1, IC1.3 (TC)
unnamed: C10.1, R13.2
unnamed: C11.+, C12.2, IC1.6 (VCC), R10.1, R14.1
unnamed: C13.+, C14.2, L2.3 (2), R14.2
SWN: C10.2, D1.A, IC1.1 (SWC), L1.2

Notes on the sheet:
Wuerth# 744066221
The ratio R1/R2 and R6/R5 need to be the equal with an error of no more than 1%. Otherwise the TCA0372 will draw a huge amount of power and get hot.
Analog signal input 1.5V DC offset
TCA0372 features: up to 35V 1A output current per OP 1MHz Gain-Bandwidth-Product = 100kHz Bandwidth at x10
Speaker options: 30V DC VCC outputss +-14V AC at speaker terminal: 14V/2A = 7 Ohm min Speaker 18V DC VCC outputs +-8 AC at Speaker terminal: 8V/2A = 4 Ohm min Speaker Eg. Dayton AMT mini-8
WE-CNSW_1812
DCDC-Converter Power Supply
Ultrasonic Amplifier
5V..25V Battery input
thick loop has high dI/dt or dU/dt and should be routed as small as possible
Change R12 and R11 to adjust output voltage
Low Pass Input Filter to suppress DAC switching noise
DC-blocking filter and power combiner
double x10 amplifier
220µH

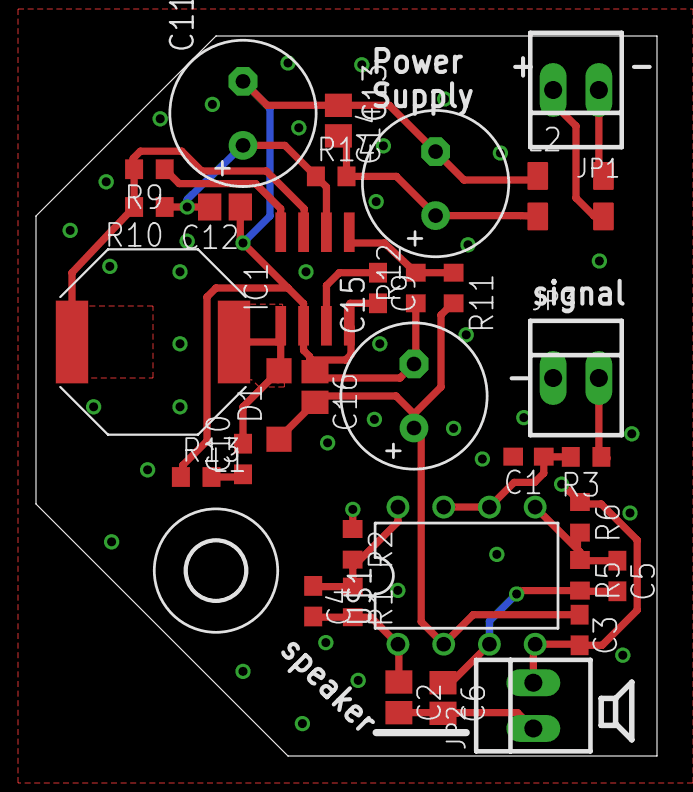
[picture p24: board amplifier_v3.brd from above]

Board: 2 copper layers, 34.5 x 40.0 mm, 34 parts (0 on the bottom side), 19 nets.
