54600B/ultrasonic-beacon/software/beacon-uC/US_Beacon_V3/Inc/constants.h

#ifndef CONSTANTS_H_
#define CONSTANTS_H_
//7 channel below 40kHz 
const uint32_t sender[7][4096] = {
{1638, 1637, 1635, 1633, 1631, 1632, 1634, 1638, 1643, 1649, 1653, 1655, 1654, 1648, 1640, 1630, 1621, 1614, 1612, 1615, 
1623, 1635, 1649, 1662, 1671, 1675, 1671, 1661, 1645, 1627, 1610, 1598, 1593, 1597, 1610, 1629, 1651, 1671, 1686, 1693, 
1688, 1674, 1652, 1626, 1602, 1584, 1576, 1580, 1596, 1621, 1649, 1677, 1698, 1707, 1704, 1687, 1661, 1629, 1599, 1575, 
1564, 1566, 1583, 1612, 1645, 1679, 1704, 1718, 1716, 1699, 1670, 1634, 1599, 1571, 1556, 1557, 1573, 1603, 1640, 1676, 
1706, 1722, 1723, 1707, 1678, 1641, 1603, 1572, 1554, 1552, 1567, 1596, 1633, 1671, 1702, 1721, 1724, 1711, 1683, 1647, 
1610, 1578, 1558, 1554, 1566, 1592, 1627, 1663, 1694, 1714, 1719, 1709, 1685, 1652, 1618, 1588, 1568, 1563, 1571, 1593, 
1623, 1655, 1683, 1702, 1708, 1701, 1682, 1655, 1626, 1601, 1583, 1577, 1583, 1599, 1622, 1647, 1669, 1685, 1691, 1686, 
1673, 1654, 1633, 1614, 1601, 1596, 1599, 1610, 1625, 1641, 1655, 1665, 1669, 1667, 1659, 1649, 1638, 1628, 1622, 1619, 
1621, 1626, 1632, 1638, 1643, 1645, 1645, 1643, 1641, 1639, 1638, 1639, 1642, 1644, 1646, 1647, 1644, 1640, 1633, 1626, 
1620, 1617, 1619, 1625, 1635, 1648, 1660, 1669, 1673, 1670, 1660, 1645, 1626, 1609, 1596, 1590, 1594, 1608, 1628, 1652, 
1675, 1692, 1699, 1695, 1679, 1654, 1624, 1596, 1575, 1566, 1570, 1589, 1618, 1652, 1685, 1710, 1722, 1718, 1698, 1665, 
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
0.740559, 0.254702, -0.863572, -0.245789, 1.442308, 0.553200, -1.058652, -0.521079, -1.026939, -0.184373, 4.181911, 1.314761, -6.786448, -2.240824, 7.396508, 2.426946, -5.793750, -1.810264, 3.131777, 0.818719, 
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

#endif
