54600B/ultrasonic-beacon/(commit log)

2018-07-22 as presented at rwth TI-institute
    [amplifier_v3.brd, amplifier_v3.sch, us_beacon_base_v3rf.brd, us_beacon_base_v3rf.sch]
2018-10-21 microphone amplifier board
    [knowles_mic_v2.GBL, knowles_mic_v2.GBO, knowles_mic_v2.GBP, knowles_mic_v2.GBS, knowles_mic_v2.GTL, knowles_mic_v2.GTO, knowles_mic_v2.GTP, knowles_mic_v2.GTS]
