54600B/ultrasonic-beacon/(notices)

Notices in the files:
software/beacon-uC/US_Beacon_V3/Src/main.c:
(C) COPYRIGHT STMicroelectronics *****END OF FILE
parts and their libraries:
Wurth_Elektronik_Passive_rev15b: Copyright: Würth Elektronik
